frankyhub/Robo_Arm/3D/Servo-Aufnahme.scad

linear_extrude(height = 3)
import ("Servo-Aufnahme.svg");
