frankyhub/Robo_Arm/3D/Staender.scad

linear_extrude(height = 3)
import ("Staender.svg");
