frankyhub/Robo_Arm/(list of files, cad)

Other CAD files:
3D/Zange.scad
