frankyhub/Robo_Arm/(commit log)

2024-02-24 V1.0 24.02.2024
    [Distanzhuelse.scad, Drehknopf.scad, Greifarmplatte.scad, Servo-Aufnahme.scad, Staender.scad, Zange-Aufsatz.scad, Zange.scad]
2026-10-12 V12102026
    Removed sections related to the Robo Arm assembly instructions and images.
